audevuilli/waspi/docs/images/wasp_enclosure.jpg

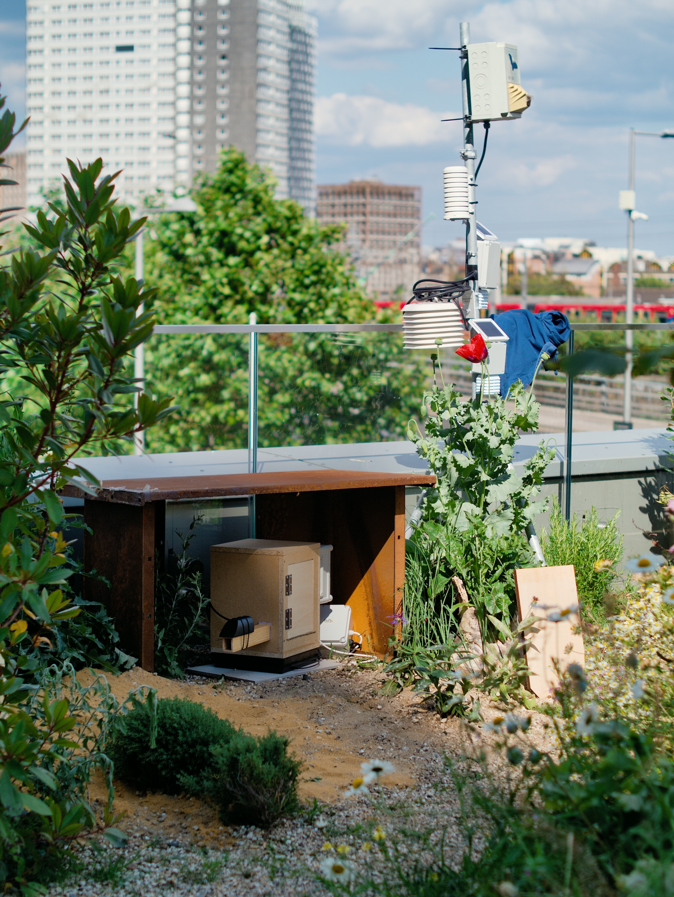
docs/images/wasp_enclosure.jpg
