audevuilli/waspi/docs/images/wasp_enclosure_vertical.jpg

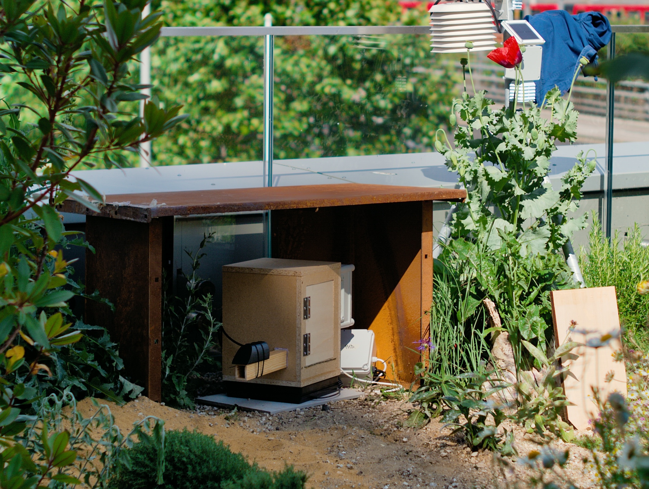
docs/images/wasp_enclosure_vertical.jpg
