audevuilli/waspi/docs/images/waspi_software_architecture.jpeg

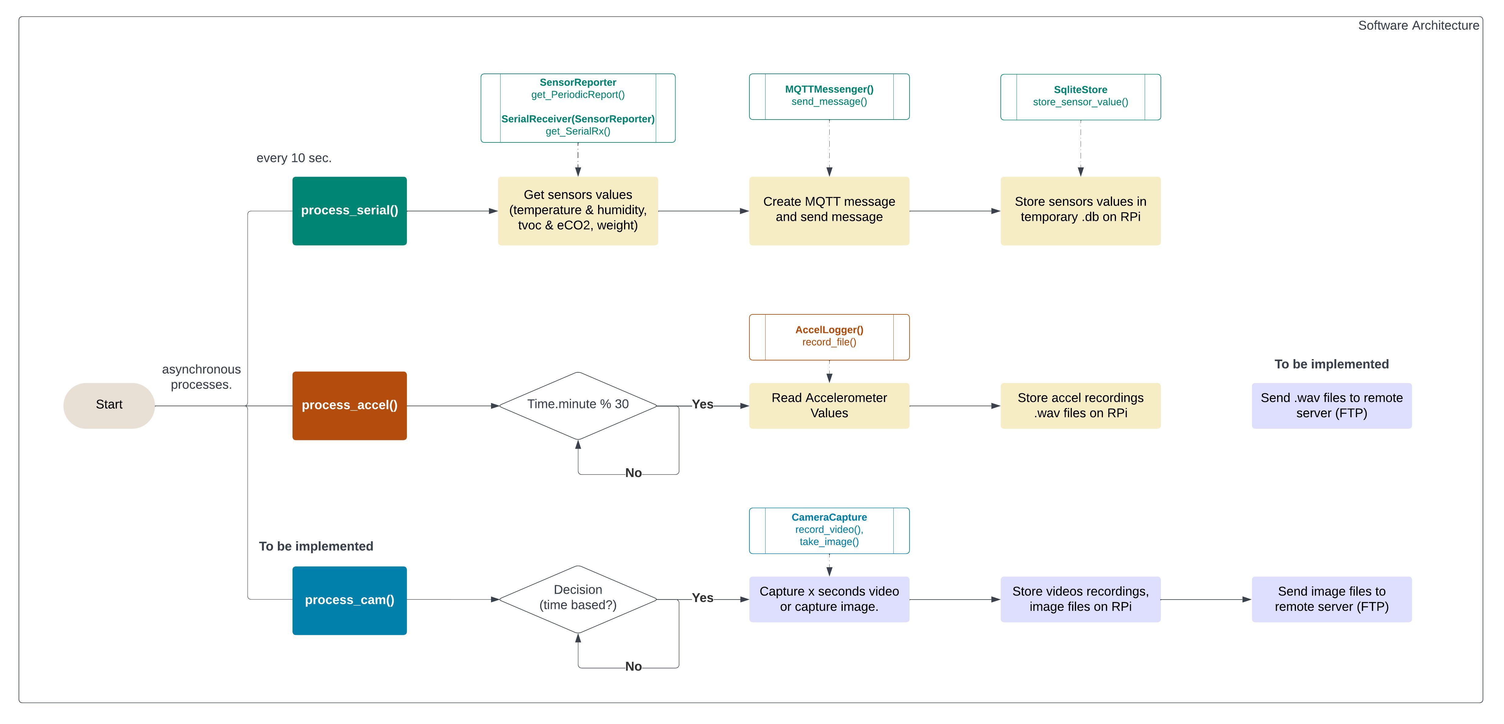
docs/images/waspi_software_architecture.jpeg
