audevuilli/waspi/docs/images/waspi_system_architecture.jpeg

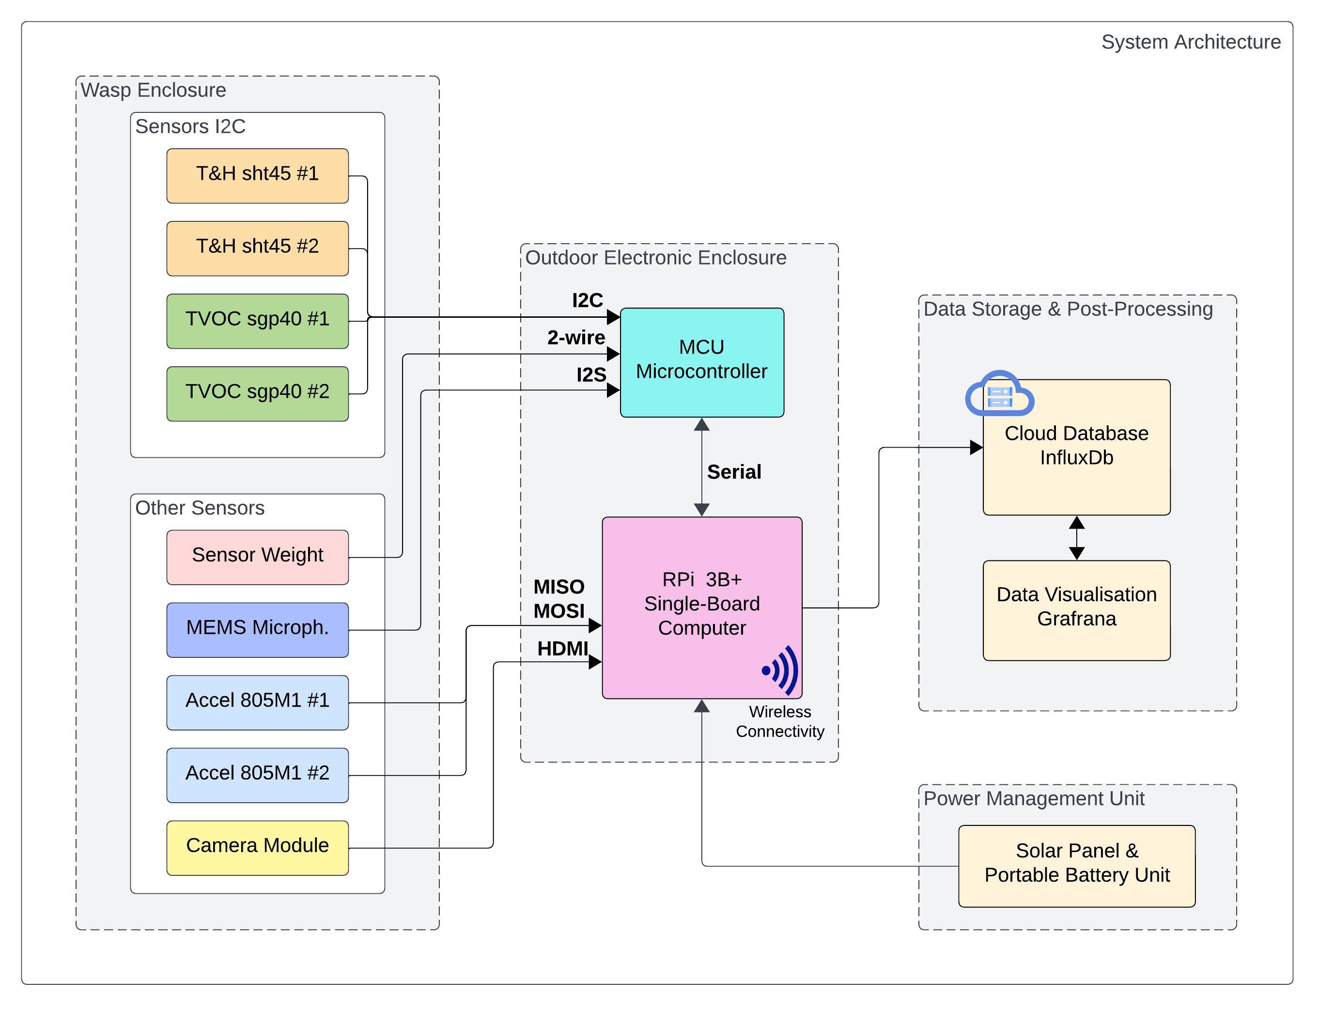
docs/images/waspi_system_architecture.jpeg
