audevuilli/waspi/docs/images/waspi_system_overview.png

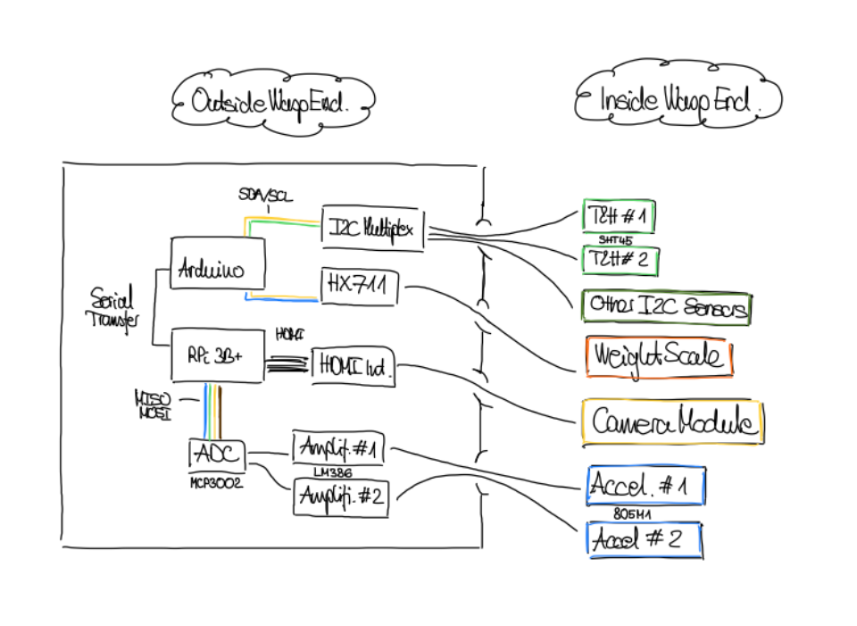
docs/images/waspi_system_overview.png
