audevuilli/waspi/docs/images/wasp_architecture_diagram.pdf

### Syst em Archit ect ure # 1

### Environment al Unit

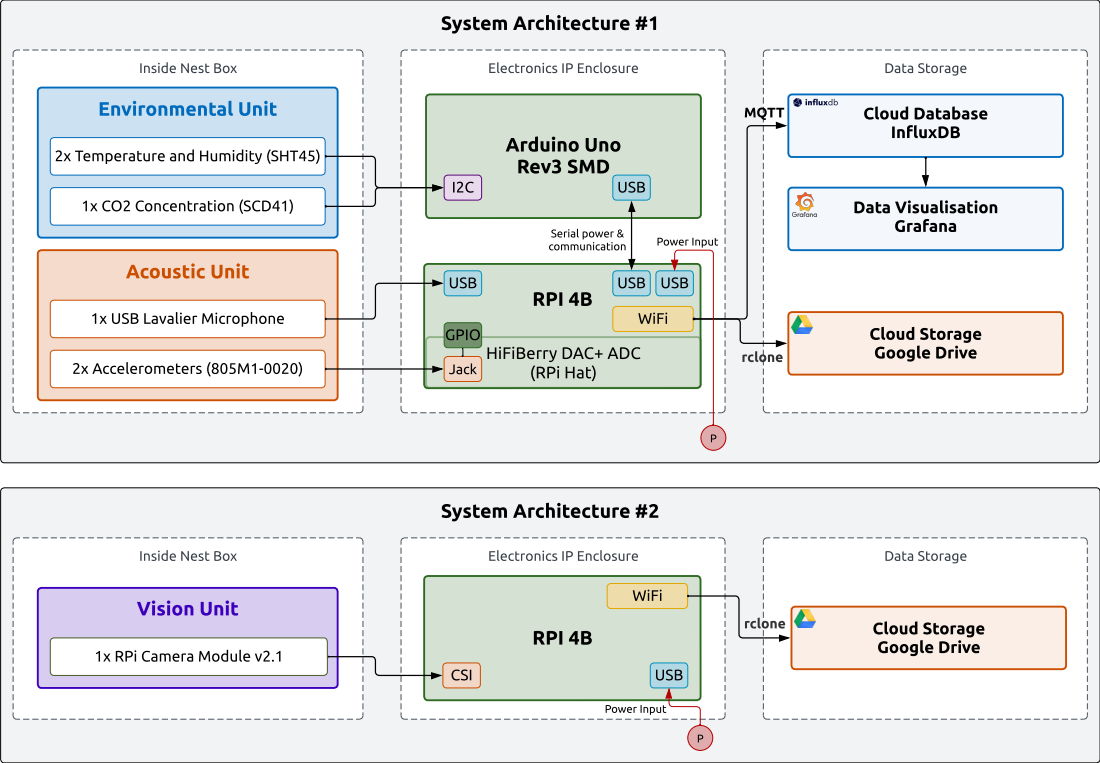
[picture p12: page 1]
Inside Nest Box; Electronics IP Enclosure; Data Storage; 1x CO2 Concentration (SCD41); 2x Accelerometers (805M1-0020); RPI 4B; (RPi Hat); Arduino Uno Rev3 SMD; USB; USB USB; Serial power & communication; WiFi; MQTT; rclone; Power Input; Vision Unit; CSI

Cloud Dat abase
Inf luxDB

2x Temperature and Humidit y (SHT45)

Dat a Visualisat ion
Grafana

Acoust ic Unit

1x USB Lavalier Microphone

GPIO
HiFiBerry DAC+ ADC
Jack

Cloud St orage
Google Drive

Syst em Archit ect ure # 2

1x RPi Camera Module v2.1
