audevuilli/waspi/src/waspi/config_mqtt_template.py

"""Template configuration for device communication."""

"""MQTT Configuration."""
DEFAULT_HOST = "yourmqtt.host.org"
DEFAULT_PORT = 1884
DEFAULT_MQTTCLIENT_USER = "your-username"
DEFAULT_MQTTCLIENT_PASS = "your-password"
DEFAULT_CLIENTID = "your-clientid"
DEFAULT_TOPIC = "user/topic/alpha"
