audevuilli/waspi/(commit log)

2023-07-20 update class SensorReader
2023-07-20 update sensor_manager
2023-07-25 create serial_reporter, update sensor_manager, and main.py
2023-07-26 update sensor_manager and main
2023-07-26 update main and sensor_manager
2023-07-26 update main.py and sensor_manager.py
2023-08-01 add asyncio to sensor_manager, messenger and main scripts
2023-08-04 update sensor_manager_list
2023-08-04 update waspi repo - create serialoutput messagebuilder types class and SerialOutput data class. Make changes to sensor_manager
2023-08-05 update sensor_manager and main.py
2023-08-07 update main, add waspi.service, update sensor_manager
2023-08-08 update sensor_manager, message_factories, data to correct mqtt json message format
    [data.py, message_factories.py, sensor_manager.py]
2023-08-23 update sensor_manager and old_main.py scripts
2023-08-23 update old_main and message_factories script. Add try, except to fetch error in getting data from serial port.
    [message_factories.py]
2023-08-29 update old_main.py and sensor_manager.py
2023-08-29 update script to read accelerometer data
2023-09-06 add db for sensors values and accel recording
2023-09-06 update database and types for sensorvalue
2023-09-07 update main and message_factories -> add message for accelerometer recordings
2023-09-07 update databse message_factories for sensorvalue save in db
2023-09-07 update database store types data - fix problem with sensorvalue db storage - dict need to be convert to str
    [data.py, main.py, types.py]
2023-10-18 add arduino waspi script to folder
2024-06-06 add scripts for camera, add backup with rclone
2024-06-20 add python class to record Accelerometer Data
2024-06-20 update main script - add accelerometer recording script
2024-06-20 create service to run entrance/exit camera motion deteciton script.
2024-06-20 move camera python scripts to src/waspi folder - camera scripts to detect motion (pixel changes).
2024-07-31 update camera script
2024-07-31 update main.py script - solve issues with asyncio.
    [main.py]
2024-08-01 update audio script - uncomment print command for debugging
2024-08-06 Wasp Enclosure Overview
2024-08-06 update arduino script to collect sensors values
2024-08-06 update main.py - add hwid to read values from arduino sensors.
2024-08-06 update camera settings
2024-08-08 update time delay in sensor manager
2024-08-08 update main.py remove uncessary print and logging
2024-08-08 Add vertical overview of the wasp enclosure
2025-02-20 add images of the wasp enclosure and system architecture
2025-02-20 switch package management to uv
2025-05-23 update gitrepo with config from deployed device
2025-05-23 adjust hw device info for accel rec
2025-06-07 update waspi arduino script
2025-06-07 update the arduino script to send data transfer every 2 minutes
