audevuilli/waspi/docs/images/electronics_top_01.jpeg

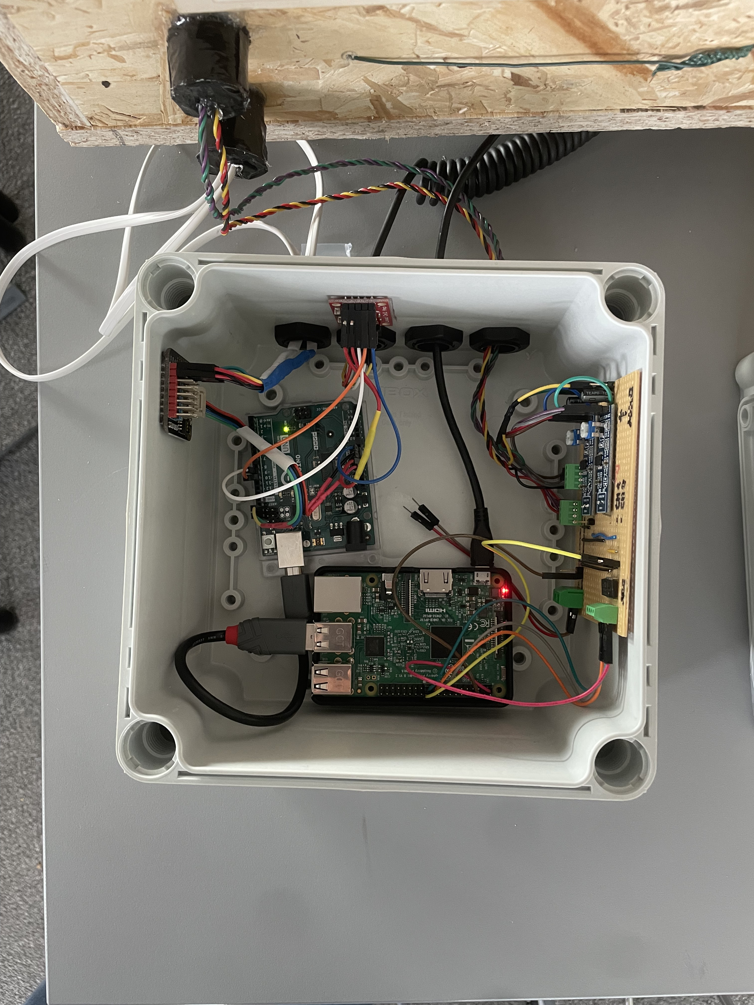
docs/images/electronics_top_01.jpeg
