audevuilli/waspi/docs/images/wasp_enclosure.JPEG

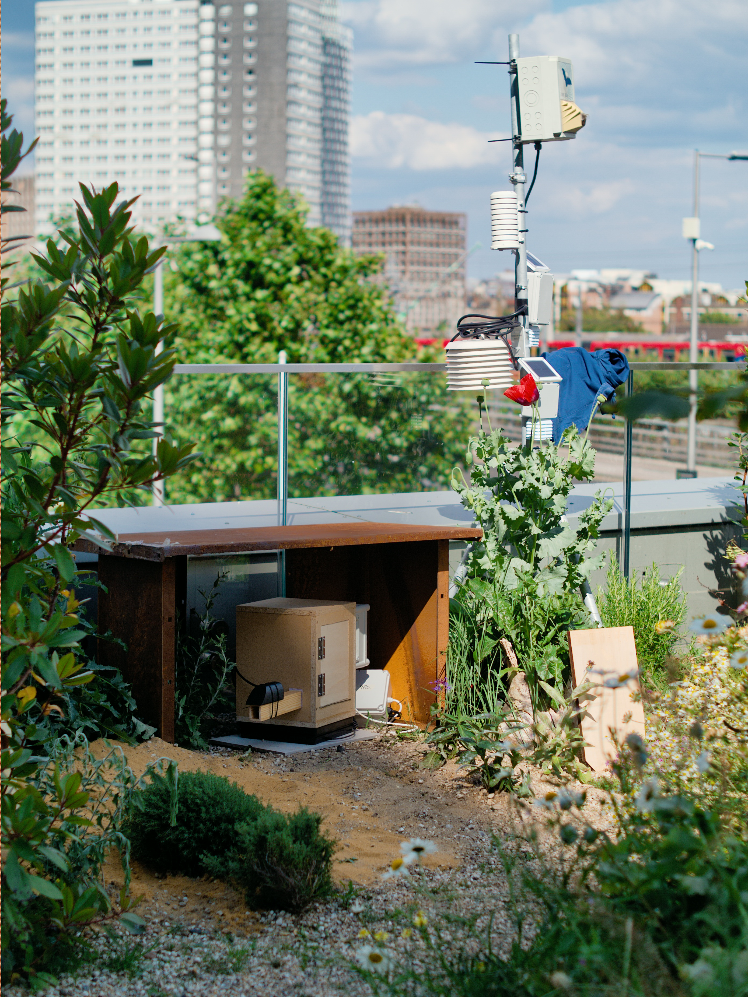
docs/images/wasp_enclosure.JPEG
