audevuilli/waspi/docs/images/setup_top_02.jpeg

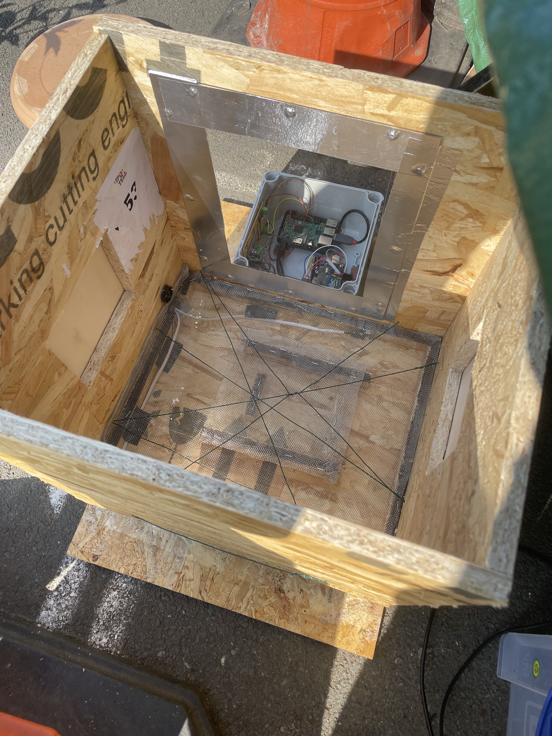
docs/images/setup_top_02.jpeg
